mlab-modules/BP02/doc/src/img/BP02A_inductors_onto_capacitors.jpg

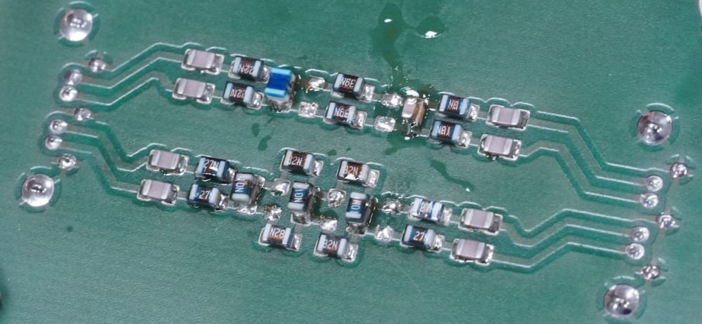
doc/src/img/BP02A_inductors_onto_capacitors.jpg
