mlab-modules/BP02/README.md

# BP02 - Symmetrical RF filter with SATA connectors on input and output 

It is used for testing RF SMD standard components-based RF filter designs.

NanoVNA measurement setup
