mlab-modules/BP02/doc/gen/README.md

# PCB

Board size: 60.45x40.13 mm (2.38x1.58 inches)

- This is the size of the rectangle that contains the board
- Thickness: 1.6 mm (63 mils)
- Material: FR4
- Finish: None
- Layers: 2
- Copper thickness: 35 µm

Solder mask: TOP / BOTTOM

- Color: Green

Silk screen: TOP / BOTTOM

- Color: White

Stackup:

| Name | Type | Color | Thickness | Material | Epsilon_r | Loss tangent |
|---|---|---|---|---|---|---|
| F.SilkS | Top Silk Screen | | | | | |
| F.Paste | Top Solder Paste | | | | | |
| F.Mask | Top Solder Mask | Green | 10 | | | |
| F.Cu | copper | | 35 | | | |
| dielectric 1 | core | | 1510 | FR4 | 4.5 | 0.020 |
| B.Cu | copper | | 35 | | | |
| B.Mask | Bottom Solder Mask | Green | 10 | | | |
| B.Paste | Bottom Solder Paste  | | | | | |
| B.SilkS | Bottom Silk Screen | | | | | |

# Important sizes

Clearance: 0.15 mm (6 mils)

Track width: 0.6 mm (24 mils)

- By design rules: 0.2 mm (8 mils)

Drill: 0.85 mm (33 mils)

- Vias: N/A mm (N/A mils) [Design: 0.4 mm (16 mils)]
- Pads: 0.85 mm (33 mils)
- The above values are real drill sizes, they add 0.1 mm (4 mils) to plated holes (PTH)

Via: N/A/N/A mm (N/A/N/A mils)

- By design rules: 0.4/0.3 mm (16/12 mils)
- Micro via: yes [0.2/0.1 mm (8/4 mils)]
- Buried/blind via: yes
- Total: 0 (thru: 0 buried/blind: 0 micro: 0)

Outer Annular Ring: 0.13 mm (5 mils)

- By design rules: 0.13 mm (5 mils)

Eurocircuits class: 6A
- Using min drill 0.85 mm for an OAR of 0.13 mm

# General stats

Components count: (SMD/THT)

- Top: 0/6 (THT)
- Bottom: 32/0 (SMD)

Defined tracks:

Used tracks:

- 0.6 mm (24 mils) (111) defined: no

Defined vias:

Used vias:

Holes (excluding vias):

- 0.74 mm (29 mils) (14)
- 1.35 mm (53 mils) (4)
- 3.0 mm (118 mils) (4)

Oval holes:

Drill tools (including vias and computing adjusts and rounding):

- 0.85 mm (33 mils) (14)
- 1.45 mm (57 mils) (4)
- 3.1 mm (122 mils) (4)
