mlab-modules/BP02/doc/gen/img/BP02-bottom.png

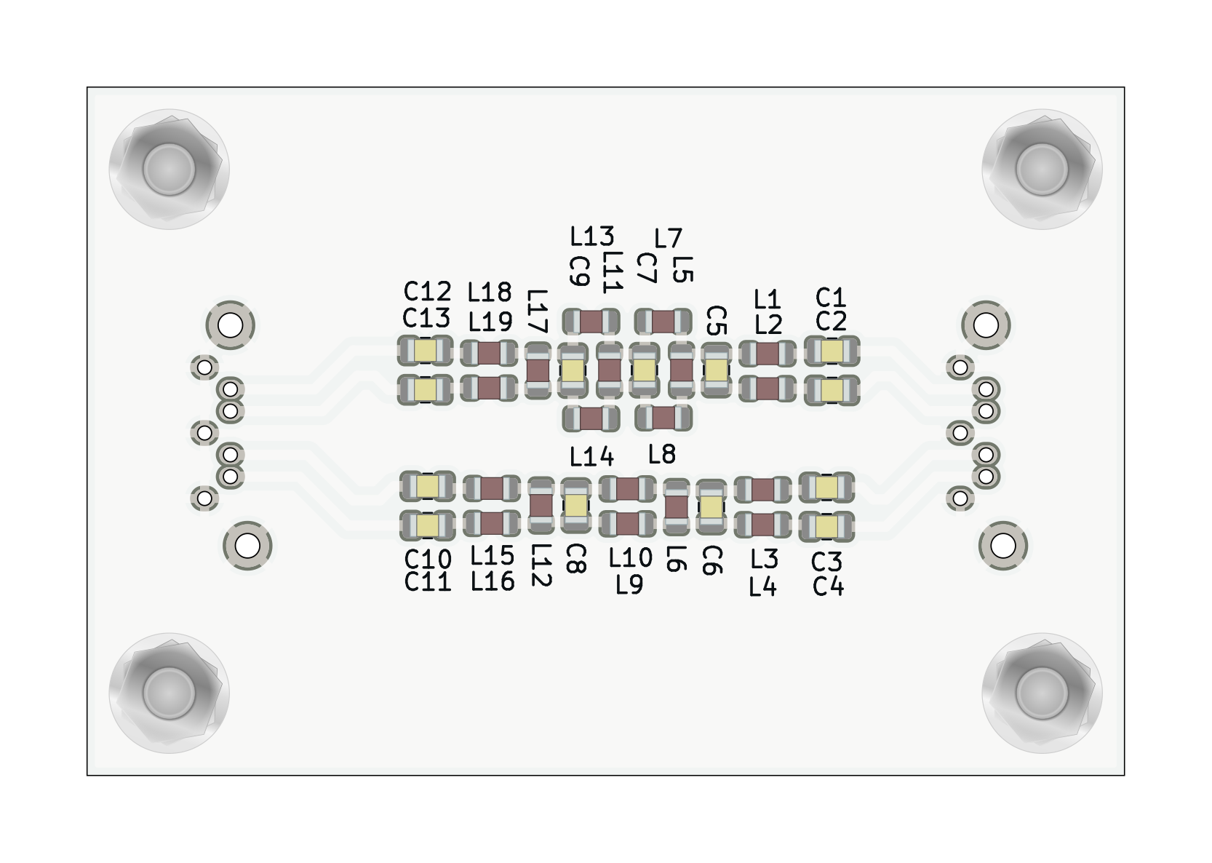
doc/gen/img/BP02-bottom.png
