mlab-modules/BP02/doc/gen/img/BP02-top.png

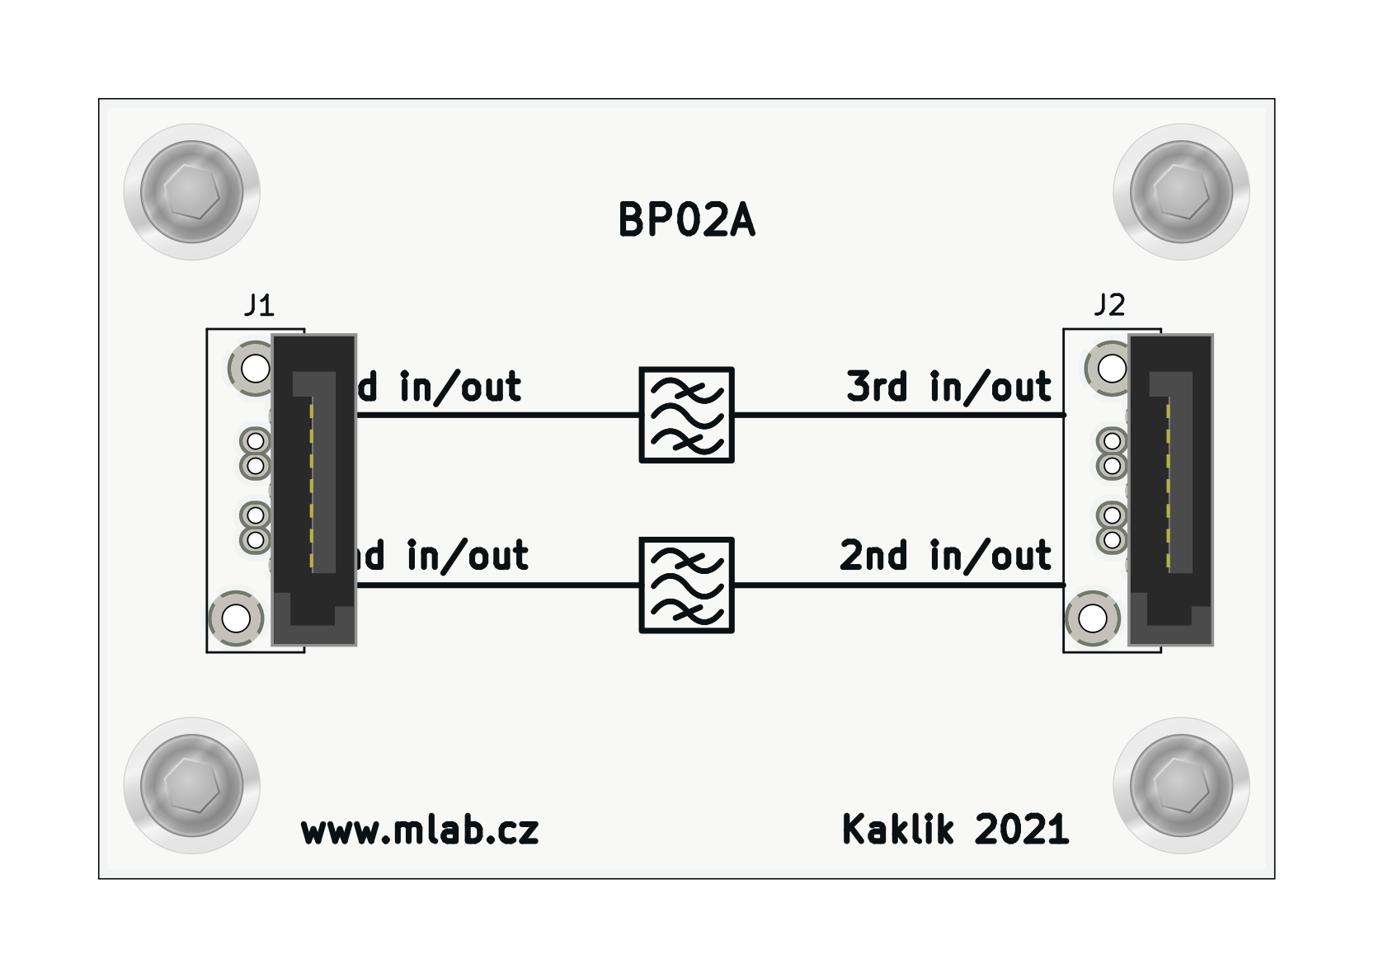
doc/gen/img/BP02-top.png
