mlab-modules/BP02/doc/src/img/2_stage_comparison.png

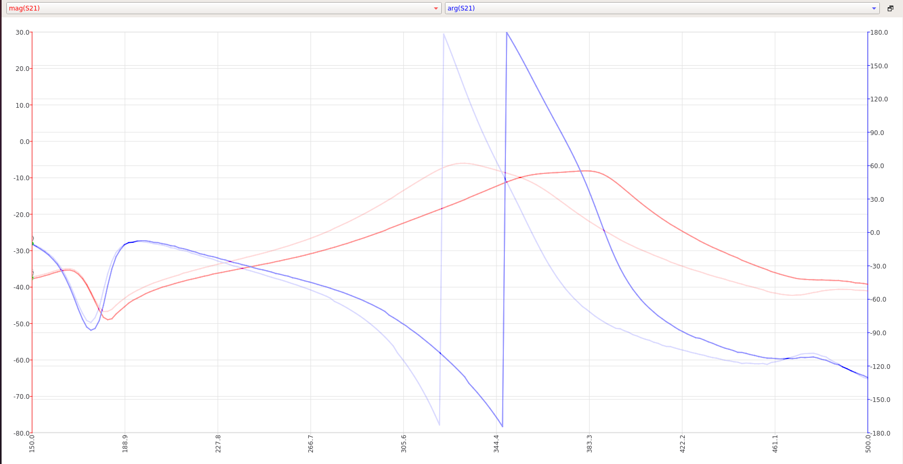
doc/src/img/2_stage_comparison.png
