mlab-modules/BP02/doc/src/img/2_stage_onto.png

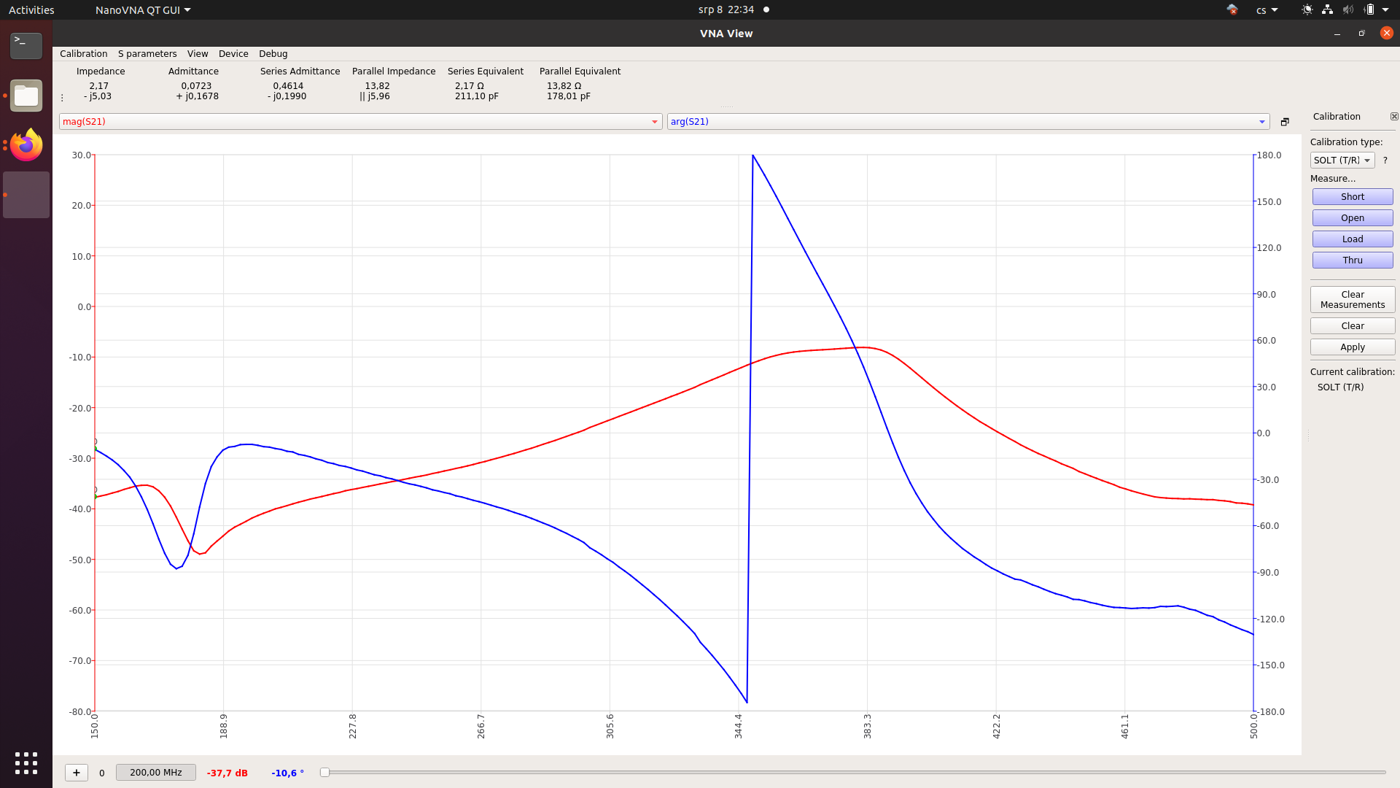
doc/src/img/2_stage_onto.png
