mlab-modules/BP02/doc/src/img/2_stage_side.png

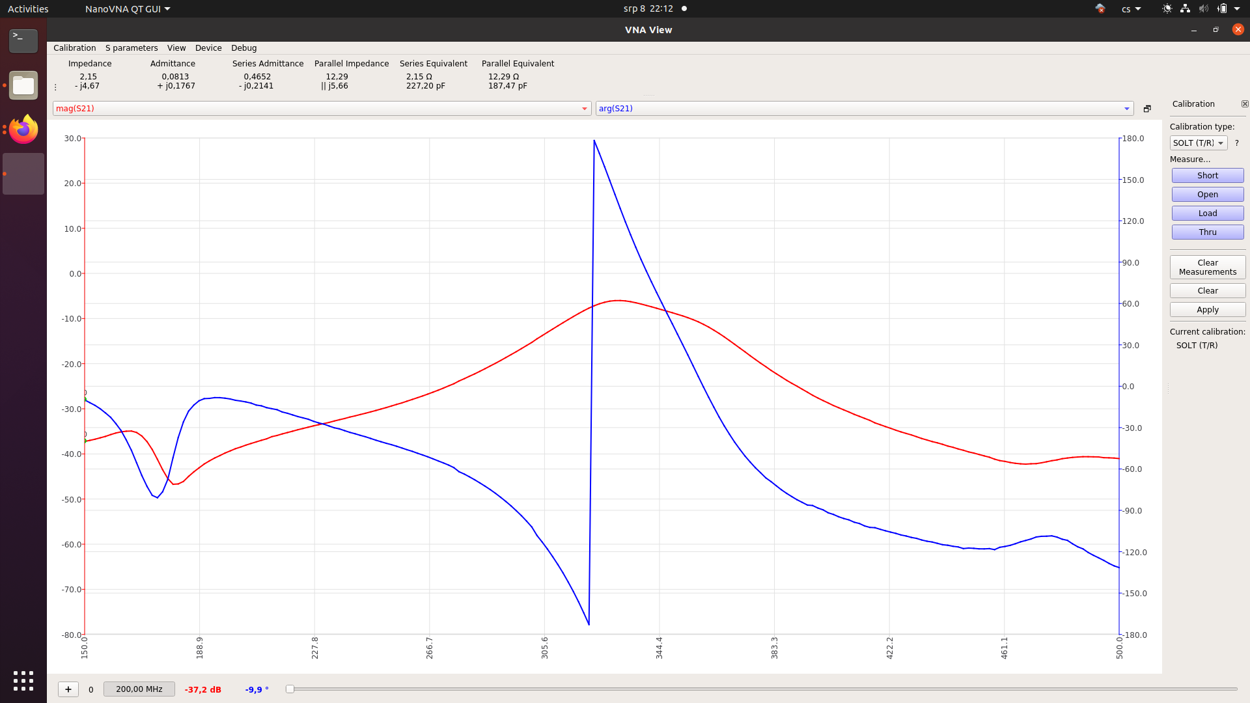
doc/src/img/2_stage_side.png
