mlab-modules/BP02/doc/src/img/3_stage_406-410MHz.png

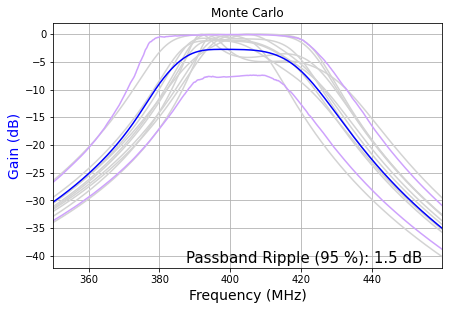
doc/src/img/3_stage_406-410MHz.png
