mlab-modules/BP02/doc/src/img/3_stage_comparison.png

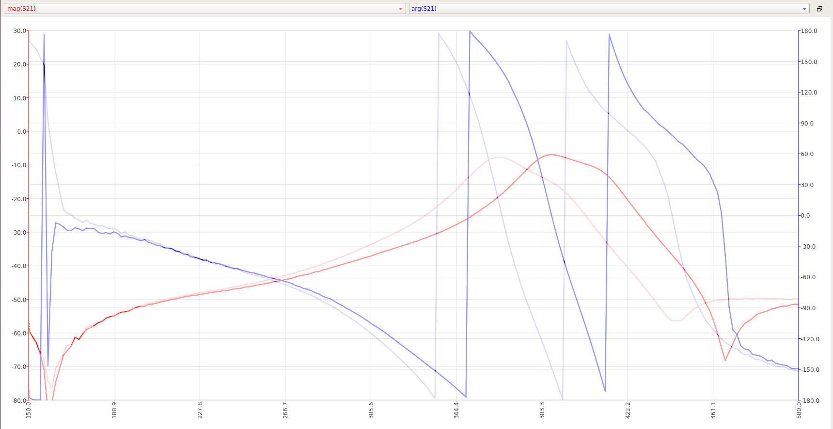
doc/src/img/3_stage_comparison.png
