mlab-modules/BP02/doc/src/img/3_stage_onto.png

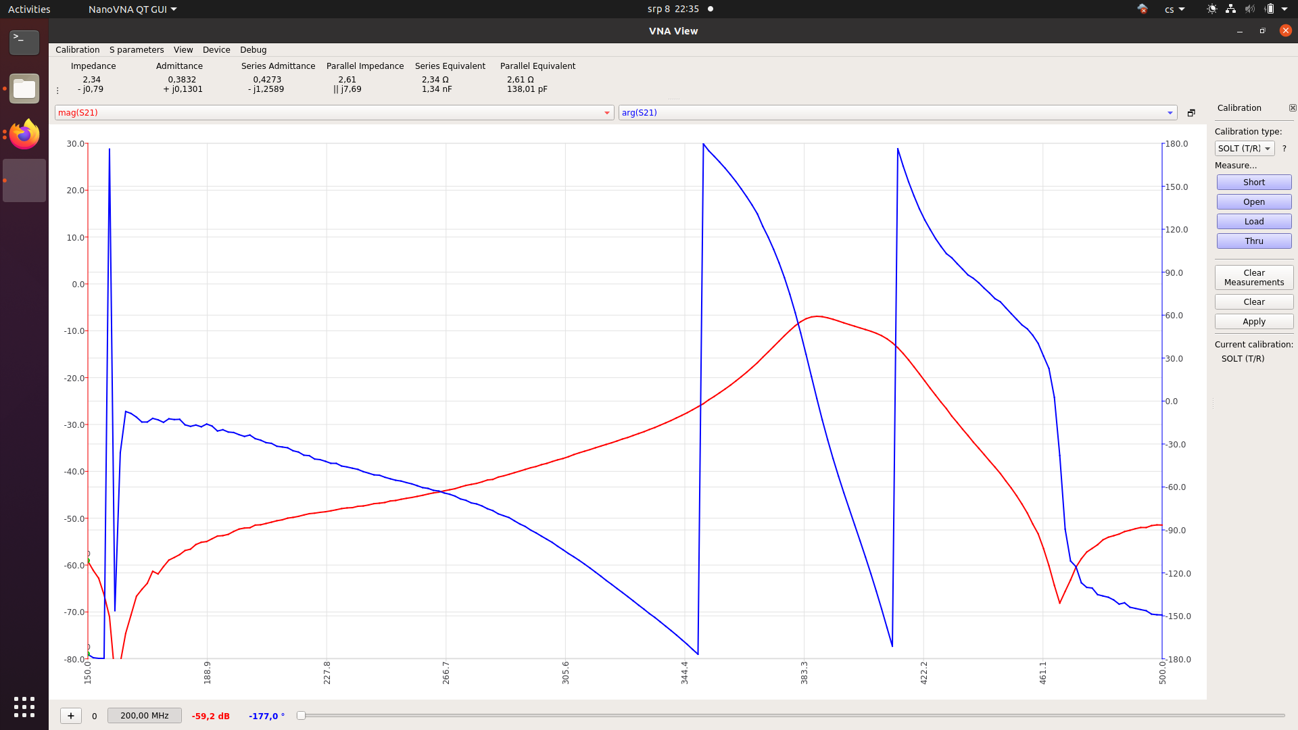
doc/src/img/3_stage_onto.png
