mlab-modules/BP02/doc/src/img/3_stage_side.png

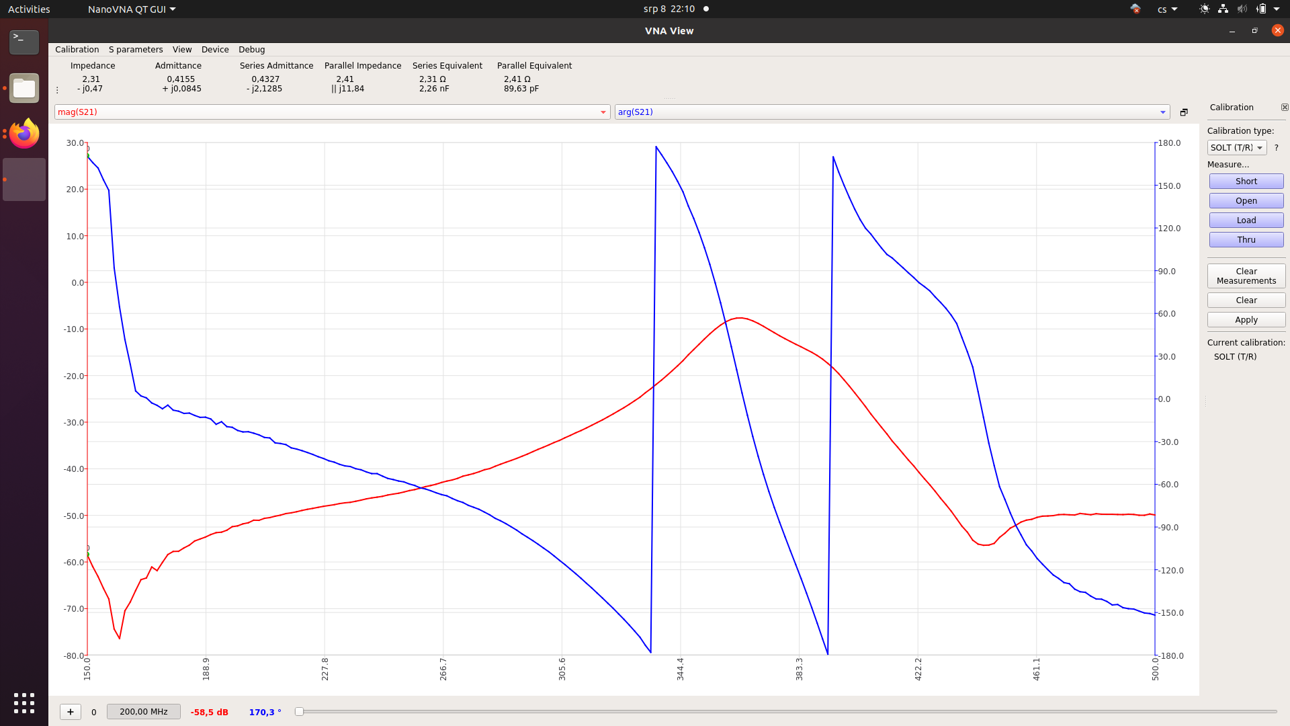
doc/src/img/3_stage_side.png
