mlab-modules/BP02/doc/src/img/serial_3and2_stages.png

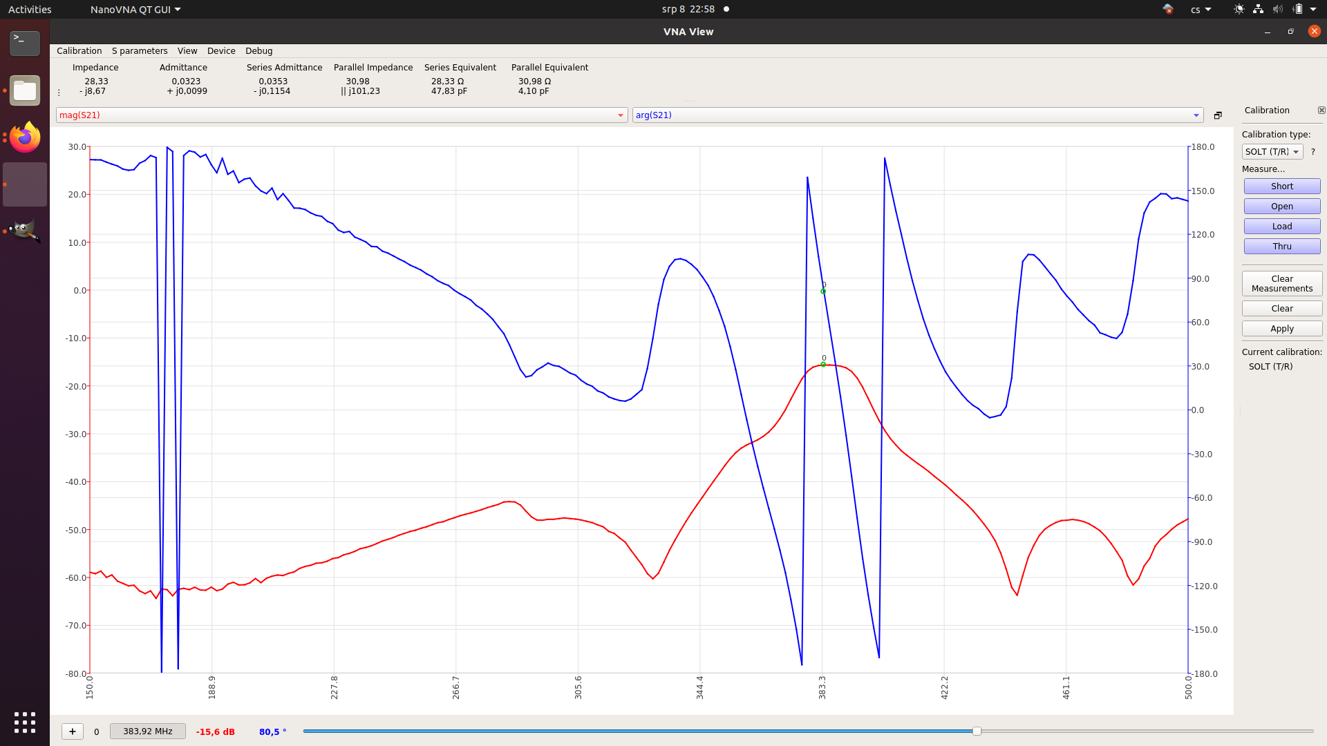
doc/src/img/serial_3and2_stages.png
