mlab-modules/BP02/doc/gen/BP02.step

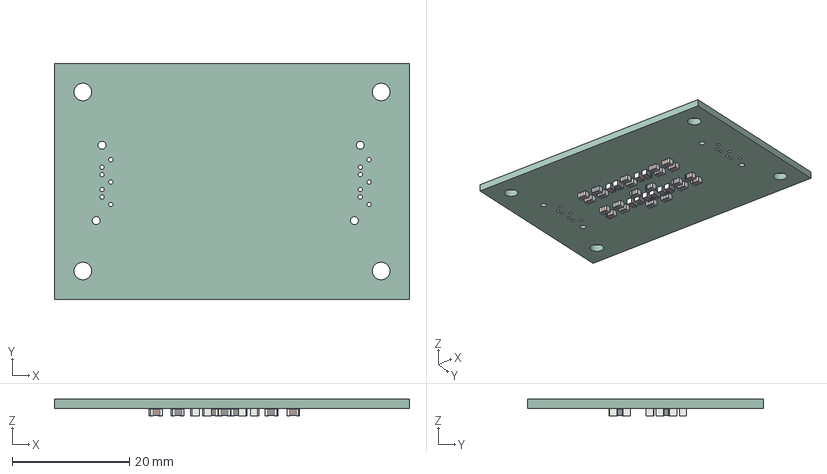
[picture p12: CAD file, 2023-09-11]
doc/gen/BP02.step
60.5 x 40.1 x 2.88 mm
tmpj9q5tlqe PCB
