mlab-modules/BP02/doc/gen/dxf/BP02-B_Cu.dxf

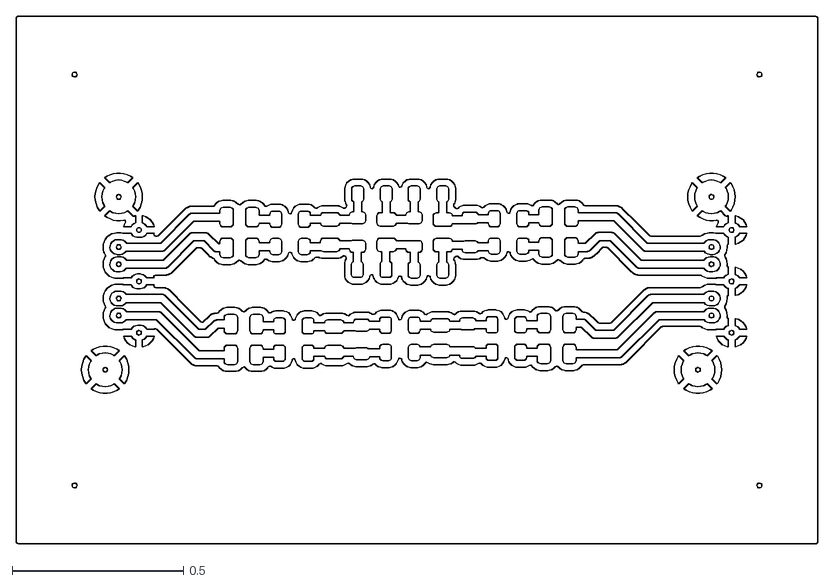
[picture p13: CAD file, 2023-09-11]
doc/gen/dxf/BP02-B_Cu.dxf
2.34 x 1.54
