mlab-modules/BP02/doc/gen/dxf/BP02-F_Cu.dxf

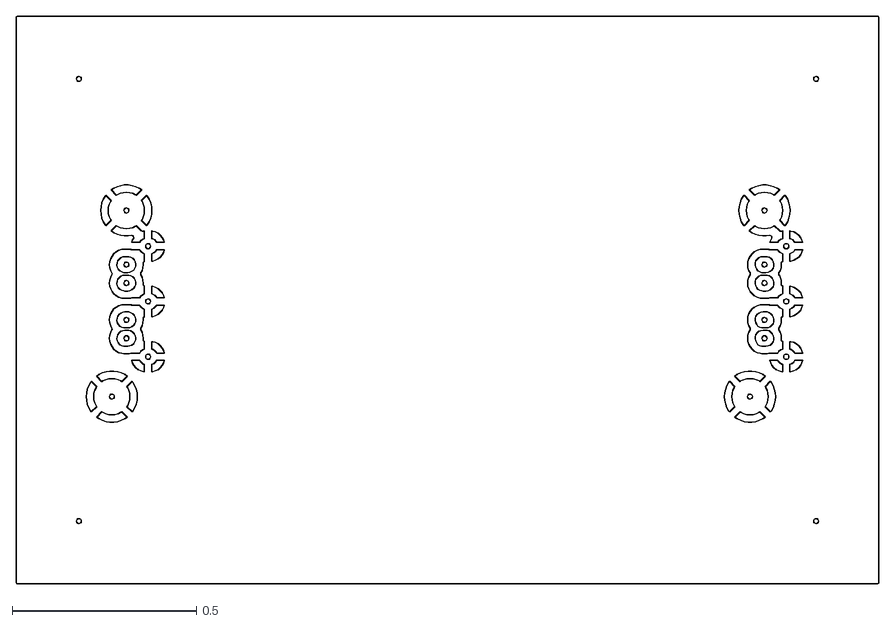
[picture p14: CAD file, 2023-09-11]
doc/gen/dxf/BP02-F_Cu.dxf
2.34 x 1.54
