mlab-modules/BP02/doc/gen/dxf/BP02-B_Courtyard.dxf

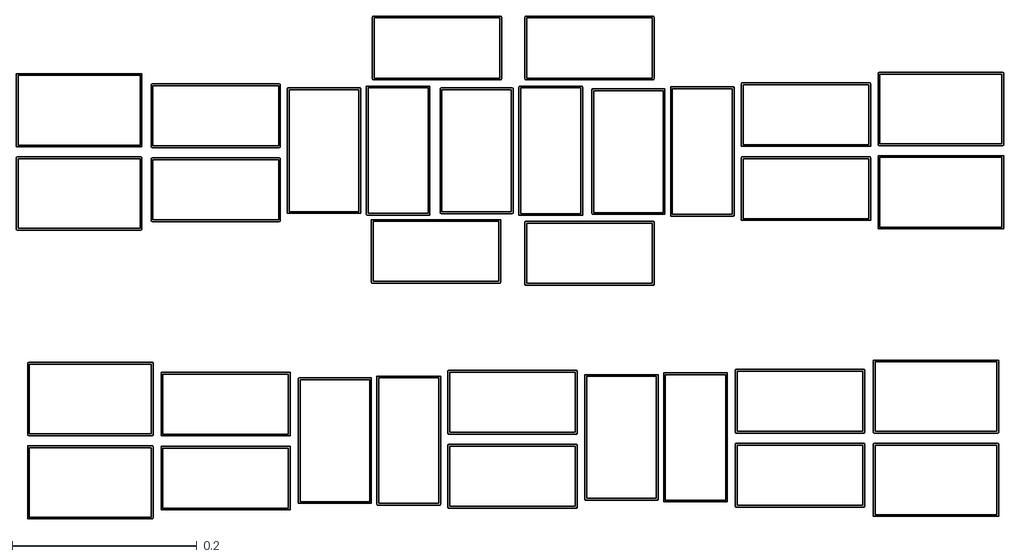
[picture p15: CAD file, 2023-07-21]
doc/gen/dxf/BP02-B_Courtyard.dxf
1.07 x 0.544
