mlab-modules/BP02/doc/gen/dxf/BP02-B_Adhesive.dxf

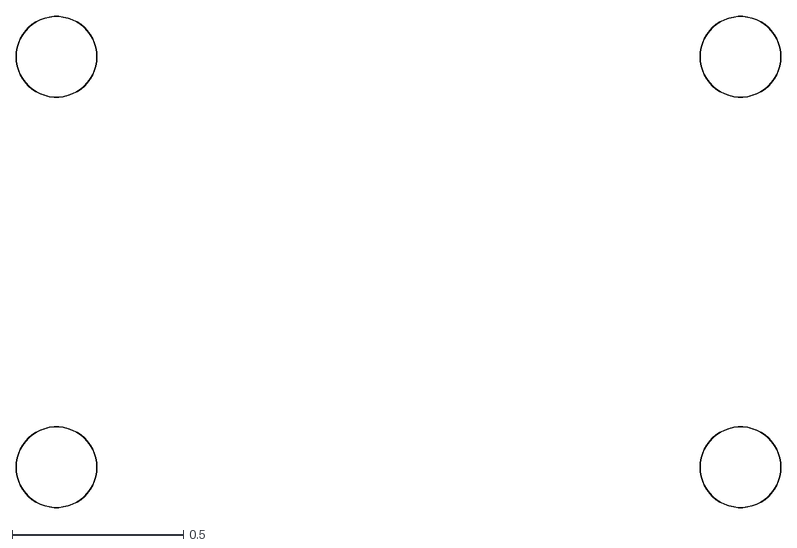
[picture p16: CAD file, 2023-07-21]
doc/gen/dxf/BP02-B_Adhesive.dxf
2.24 x 1.44
