mlab-modules/BP02/doc/gen/dxf/BP02-F_Fab.dxf

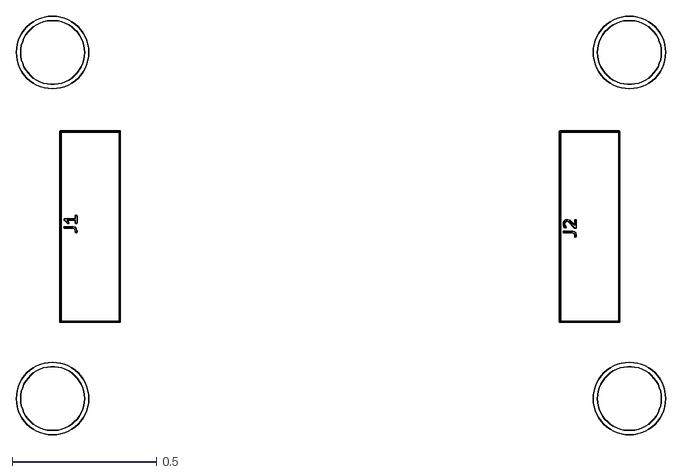
[picture p17: CAD file, 2023-07-21]
doc/gen/dxf/BP02-F_Fab.dxf
2.25 x 1.45
