mlab-modules/BP02/doc/gen/dxf/BP02-Edge_Cuts.dxf

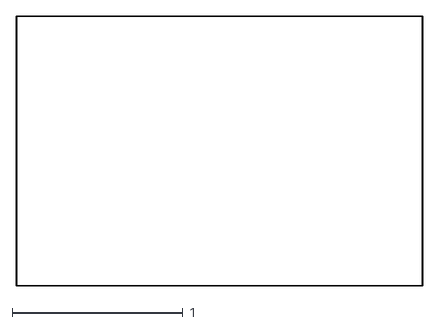
[picture p18: CAD file, 2023-07-21]
doc/gen/dxf/BP02-Edge_Cuts.dxf
2.38 x 1.58
