mlab-modules/BP02/doc/gen/dxf/BP02-B_Fab.dxf

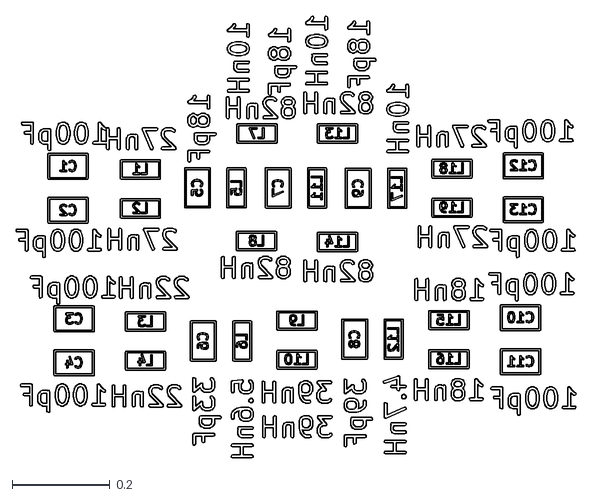
[picture p19: CAD file, 2023-07-21]
doc/gen/dxf/BP02-B_Fab.dxf
1.15 x 0.904
