mlab-modules/BP02/doc/gen/dxf/BP02-F_Courtyard.dxf

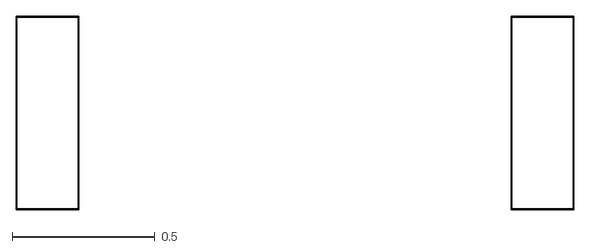
[picture p20: CAD file, 2023-07-21]
doc/gen/dxf/BP02-F_Courtyard.dxf
1.95 x 0.675
