mlab-modules/BP02/(list of files, cad)

Other CAD files:
doc/gen/dxf/BP02A-User_8.dxf
doc/gen/dxf/BP02-User_Drawings.dxf
doc/gen/dxf/BP02A-User_7.dxf
doc/gen/dxf/BP02-User_Comments.dxf
doc/gen/dxf/BP02A-User_4.dxf
doc/gen/dxf/BP02A-User_5.dxf
doc/gen/dxf/BP02-User_Eco2.dxf
doc/gen/dxf/BP02A-User_Comments.dxf
doc/gen/dxf/BP02A-User_Eco2.dxf
doc/gen/dxf/BP02-User_Eco1.dxf
doc/gen/dxf/BP02A-User_6.dxf
doc/gen/dxf/BP02A-User_1.dxf
doc/gen/dxf/BP02A-User_2.dxf
doc/gen/dxf/BP02-User_8.dxf
doc/gen/dxf/BP02-User_2.dxf
doc/gen/dxf/BP02A-Margin.dxf
doc/gen/dxf/BP02-User_6.dxf
doc/gen/dxf/BP02A-User_Eco1.dxf
doc/gen/dxf/BP02-User_7.dxf
doc/gen/dxf/BP02-User_1.dxf
doc/gen/dxf/BP02-User_5.dxf
doc/gen/dxf/BP02-User_3.dxf
doc/gen/dxf/BP02-Margin.dxf
doc/gen/dxf/BP02-User_4.dxf
doc/gen/dxf/BP02-User_9.dxf
doc/gen/dxf/BP02A-User_Drawings.dxf
doc/gen/dxf/BP02A-User_3.dxf
doc/gen/dxf/BP02A-User_9.dxf
doc/gen/dxf/BP02-B_Mask.dxf
doc/gen/dxf/BP02-B_Paste.dxf
doc/gen/dxf/BP02-B_Silkscreen.dxf
doc/gen/dxf/BP02-F_Mask.dxf
doc/gen/dxf/BP02-F_Paste.dxf
doc/gen/dxf/BP02-F_Silkscreen.dxf
doc/gen/dxf/BP02A-F_Paste.dxf
