mlab-modules/BP02/(threads)

Thread 1 (2021-05-18):

Labels PCB

ChroustJan, 2021-05-18:
@kaklik  nebylo by vhodné označit vstup a výstup na PCB:
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

kaklik, 2021-05-18:
Zkusil jsem jednoznačnost potisku vylepšit přidáním symbolu RF filtru a označit různorodost řádů filtrů na konektorech.

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

Closed 2021-05-18.

Thread 2 (2021-06-07):

Add correct identificators for OpenIntranet warehouse

kaklik, 2021-06-07:
Přidat správná označení [UST_ID](https://github.com/UniversalScientificTechnologies/OpenIntranet/wiki/KiCAD) k použitým součástkám.

kaklik, 2021-06-07:
UST_ID jsou přiřazené. Je to ke kontrole @ChroustJan

ChroustJan, 2021-06-08:
UST ID mi přijde dobré. @kaklik je potřeba uklidit B.FAB pro tisk.

kaklik, 2021-06-08:
>@kaklik je potřeba uklidit B.FAB pro tisk.

Provedeno.

ChroustJan, 2021-06-08:
V pořádku

Closed 2021-06-08.
