mlab-modules/BP02/doc/gen/BP02-schematic.pdf

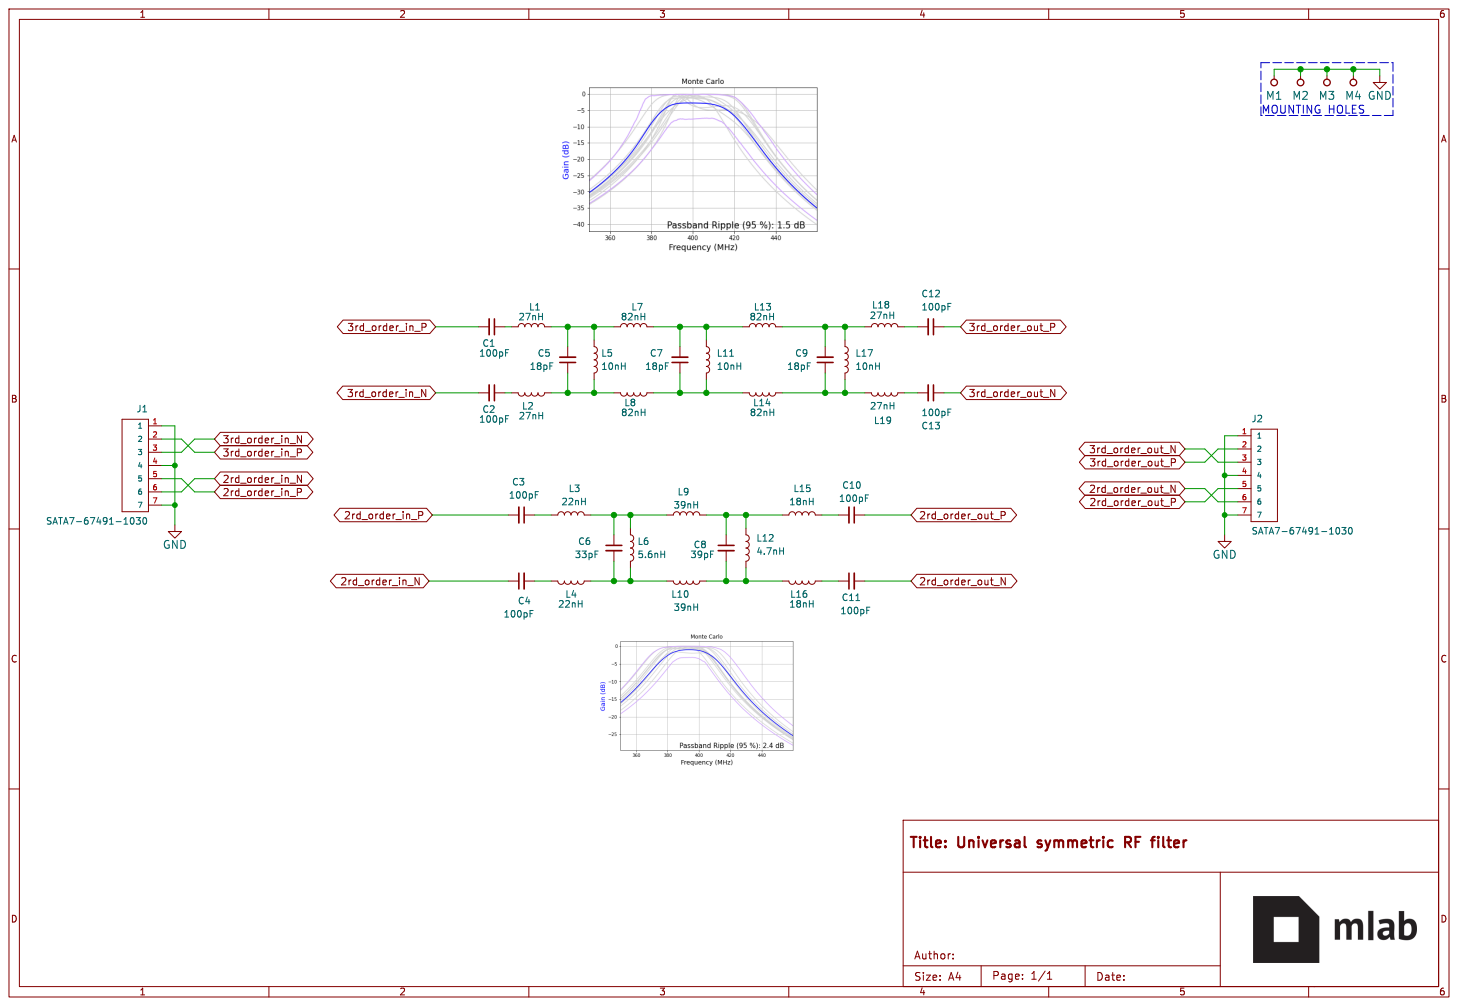
[picture p21: page 1]
