mlab-modules/BP02/hw/cam_profi/assembly/BP02-B_Fab+Edge_Cuts.pdf

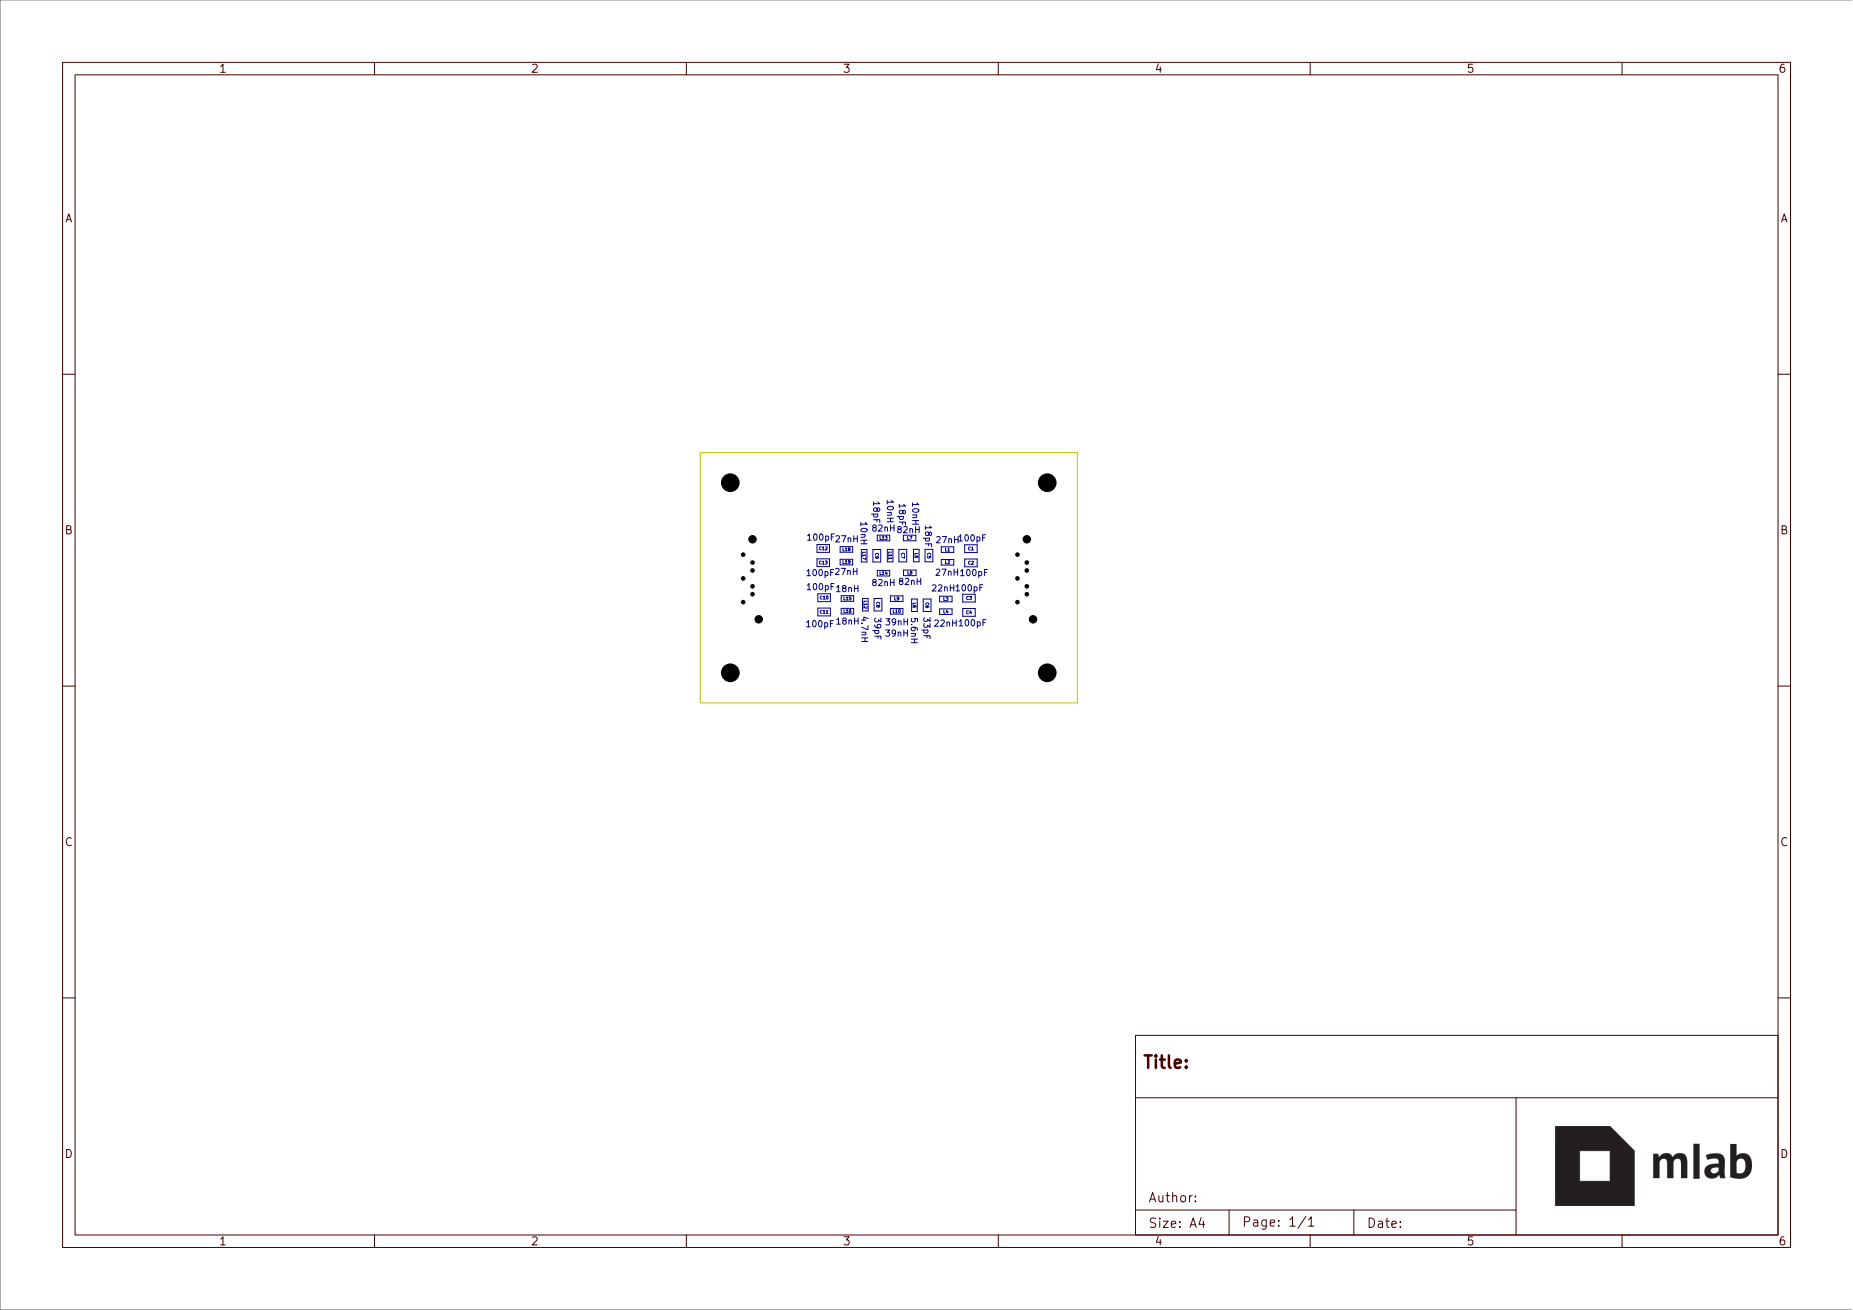
[picture p22: page 1]
