mlab-modules/BP02/hw/cam_profi/assembly/BP02-F_Fab+Edge_Cuts.pdf

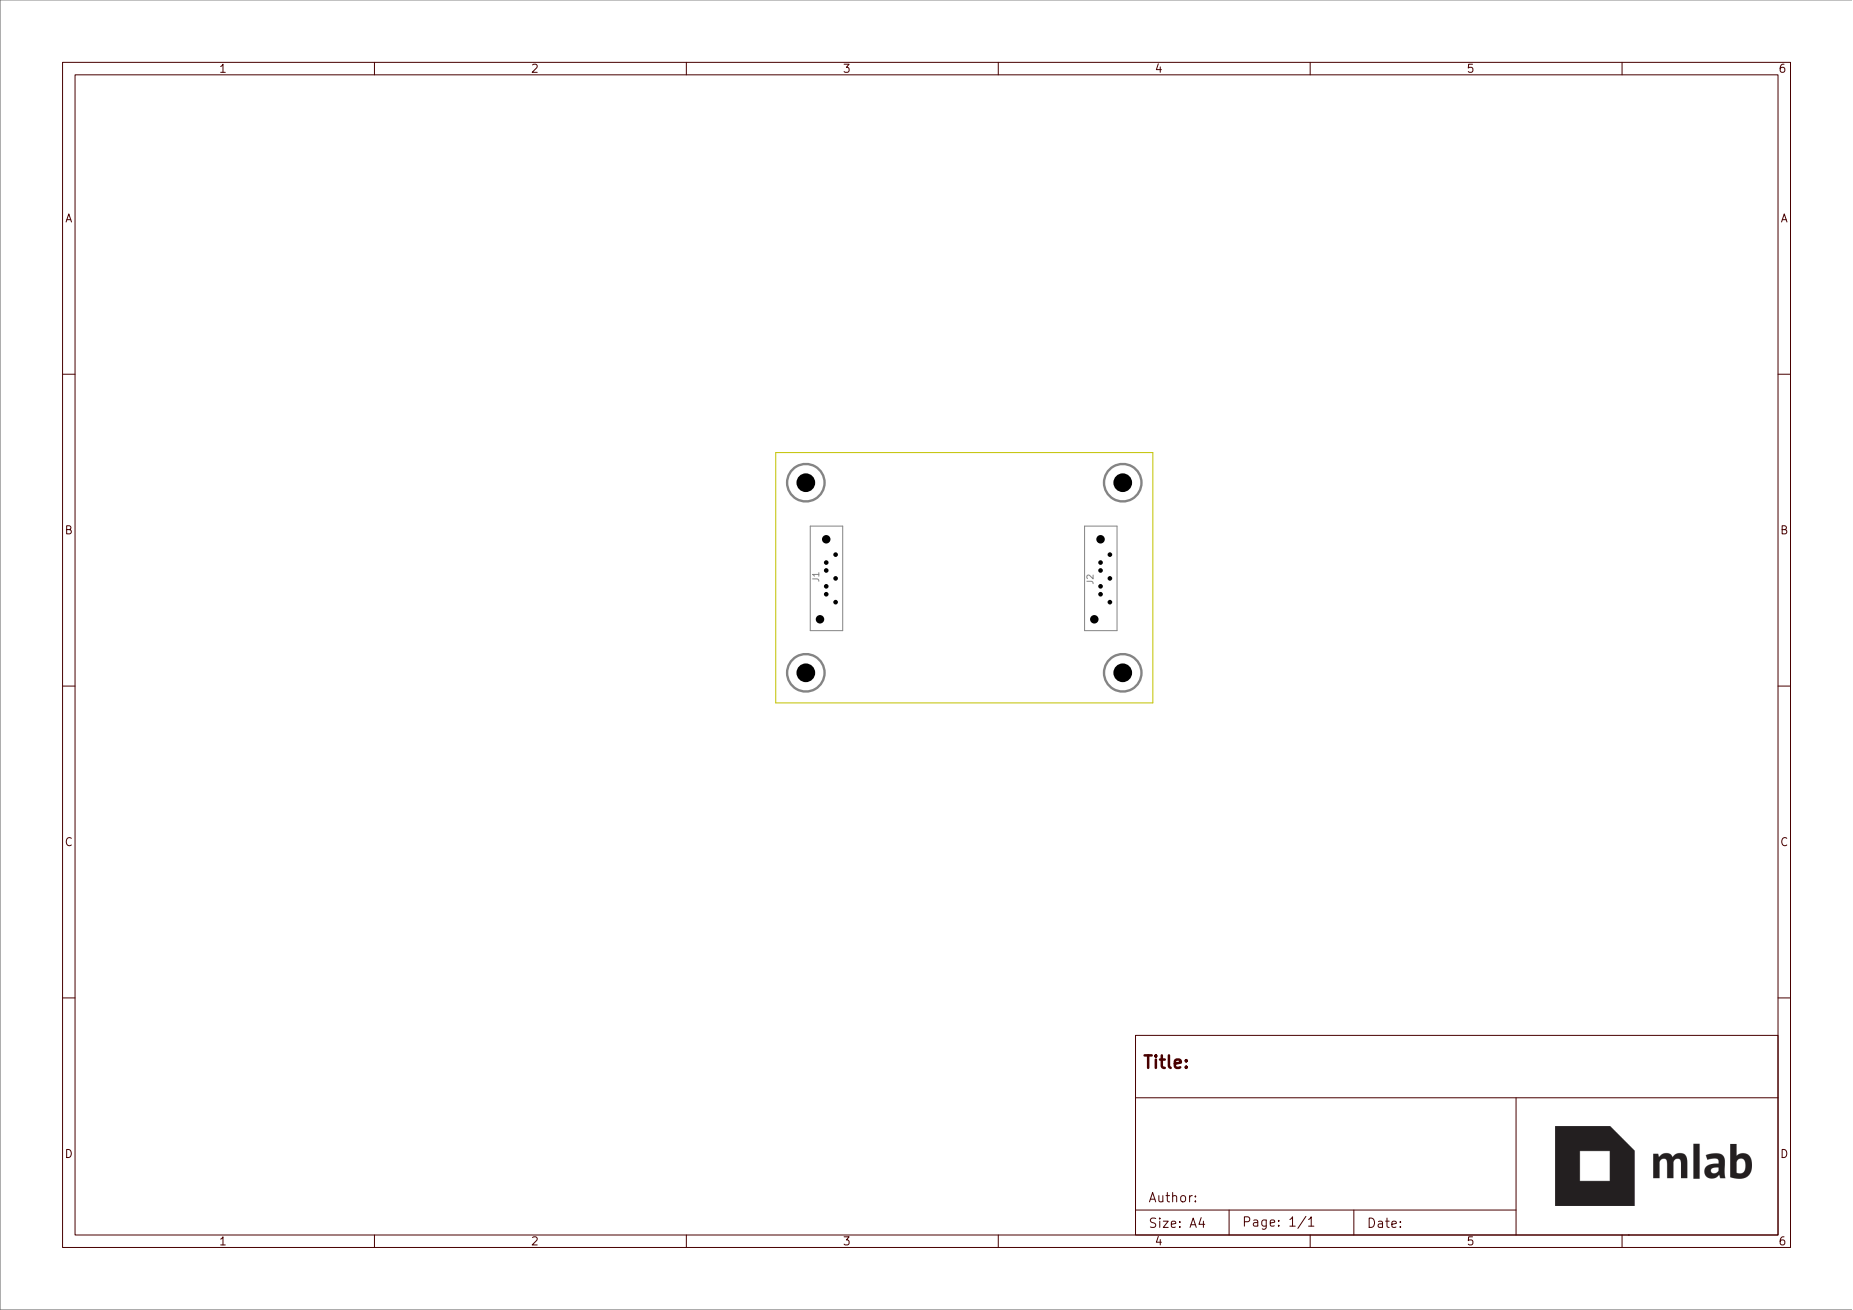
[picture p23: page 1]
