mlab-modules/BP02/(commit log)

2021-04-28 The first version of filter schematics.
    [BP02.kicad_sch]
2021-04-29 PCB layout WIP.
    [BP02.kicad_pcb, BP02.kicad_sch]
2021-04-30 1st attempt to route filter, linear filter layout.
    [BP02.kicad_pcb, BP02.kicad_sch]
2021-04-30 Geometric topology of 3rd stage filter changed to bridged.
    [BP02.kicad_pcb]
2021-05-12 Layout improvement.
    [BP02.kicad_pcb]
2021-05-17 Minor silkscreen and layout improvements.
    [BP02.kicad_pcb]
2021-05-18 generování výrobních dat
    [BP02-B_Cu.gbr, BP02-B_Mask.gbr, BP02-B_Paste.gbr, BP02-B_Silkscreen.gbr, BP02-Edge_Cuts.gbr, BP02-F_Cu.gbr, BP02-F_Mask.gbr, BP02-F_Paste.gbr]
2021-05-18 Rename KiCad project
    [BP02-B_Mask.gbr, BP02-F_Paste.gbr, BP02A-B_Cu.gbr, BP02A-B_Mask.gbr, BP02A-B_Silkscreen.gbr, BP02A-Edge_Cuts.gbr, BP02A-F_Cu.gbr, BP02A-F_Mask.gbr]
2021-05-18 Edit production data
    [BP02A.kicad_pcb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]
2021-05-18 Improve silksceen Resolve #1.
    [BP02A.kicad_pcb]
2021-05-18 Výrobní data
    [BP02A-B_Cu.gbr, BP02A-B_Mask.gbr, BP02A-B_Silkscreen.gbr, BP02A-Edge_Cuts.gbr, BP02A-F_Cu.gbr, BP02A-F_Mask.gbr, BP02A-F_Silkscreen.gbr, BP02A-NPTH.drl]
2021-06-07 Updated parts specification. #2
    [BP02A.kicad_sch]
2021-06-08 Generate boom
    [BP02A.csv]
2021-06-08 B.Fab cleanup #2.
    [BP02A.kicad_pcb]
2022-04-06 Update actions products
    [BP02A-B_Cu.gbr, BP02A-B_Mask.gbr, BP02A-Edge_Cuts.gbr, BP02A-F_Cu.gbr, BP02A-F_Mask.gbr, BP02A-F_Silkscreen.gbr, BP02A-NPTH.drl, BP02A-PTH.drl]
2022-08-08 add photo of filter measurement setup.
2022-08-11 exchanged multilayer inductor by wire wound.
    [BP02A.kicad_sch]
2023-07-05 automated commit; rename source files to new naming convence
    [BP02.kicad_pcb, BP02.kicad_sch]
2023-07-21 update to 7
    [BP02.kicad_pcb, BP02.kicad_sch]
